0clock/smartcar2022/hardware/电机驱动/danqu.PcbDoc.htm

Reporting Options

# File in Previous Format

Date | : | 2022/7/8
Time | : | 20:59:29
Filename | : | C:\Users\Jay\Desktop\my-smart-car-2022\hardware\든샙혜땡\danqu.PcbDoc

Version | Warning

This file was generated by an earlier version of the software
