0clock/smartcar2022/openart/README.md

# openart部分

1. openart1的功能是开始时识别A4纸上的坐标点，以及在搬运的过程中寻找图片位置发送给rt1064，用来纠正小车位置。
2. openart2的功能是识别图片的内容
