0clock/smartcar2022/images/m车模底盘.jpg

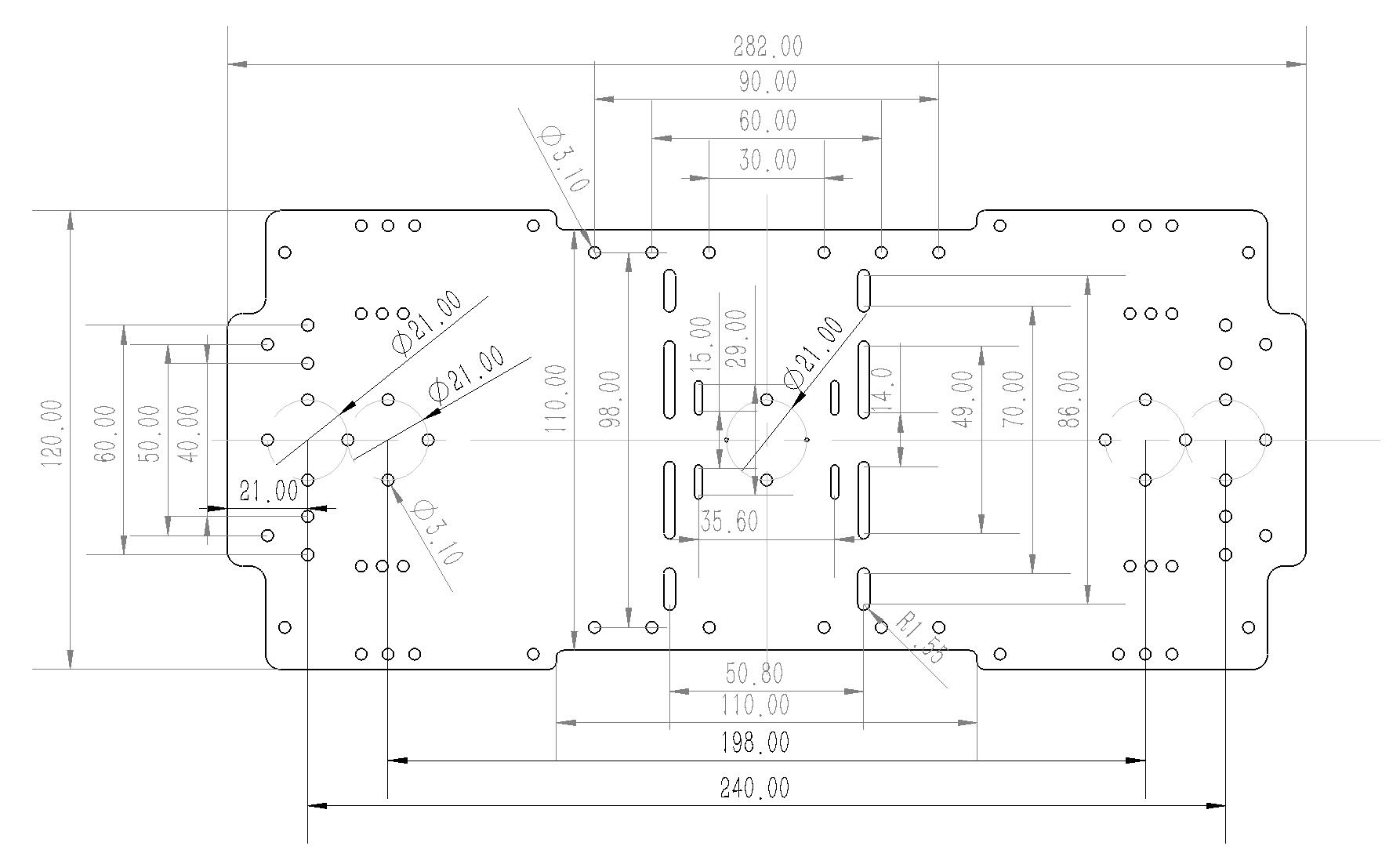
images/m车模底盘.jpg
