0clock/smartcar2022/images/Schematic_自然选择号_2022-07-16.png

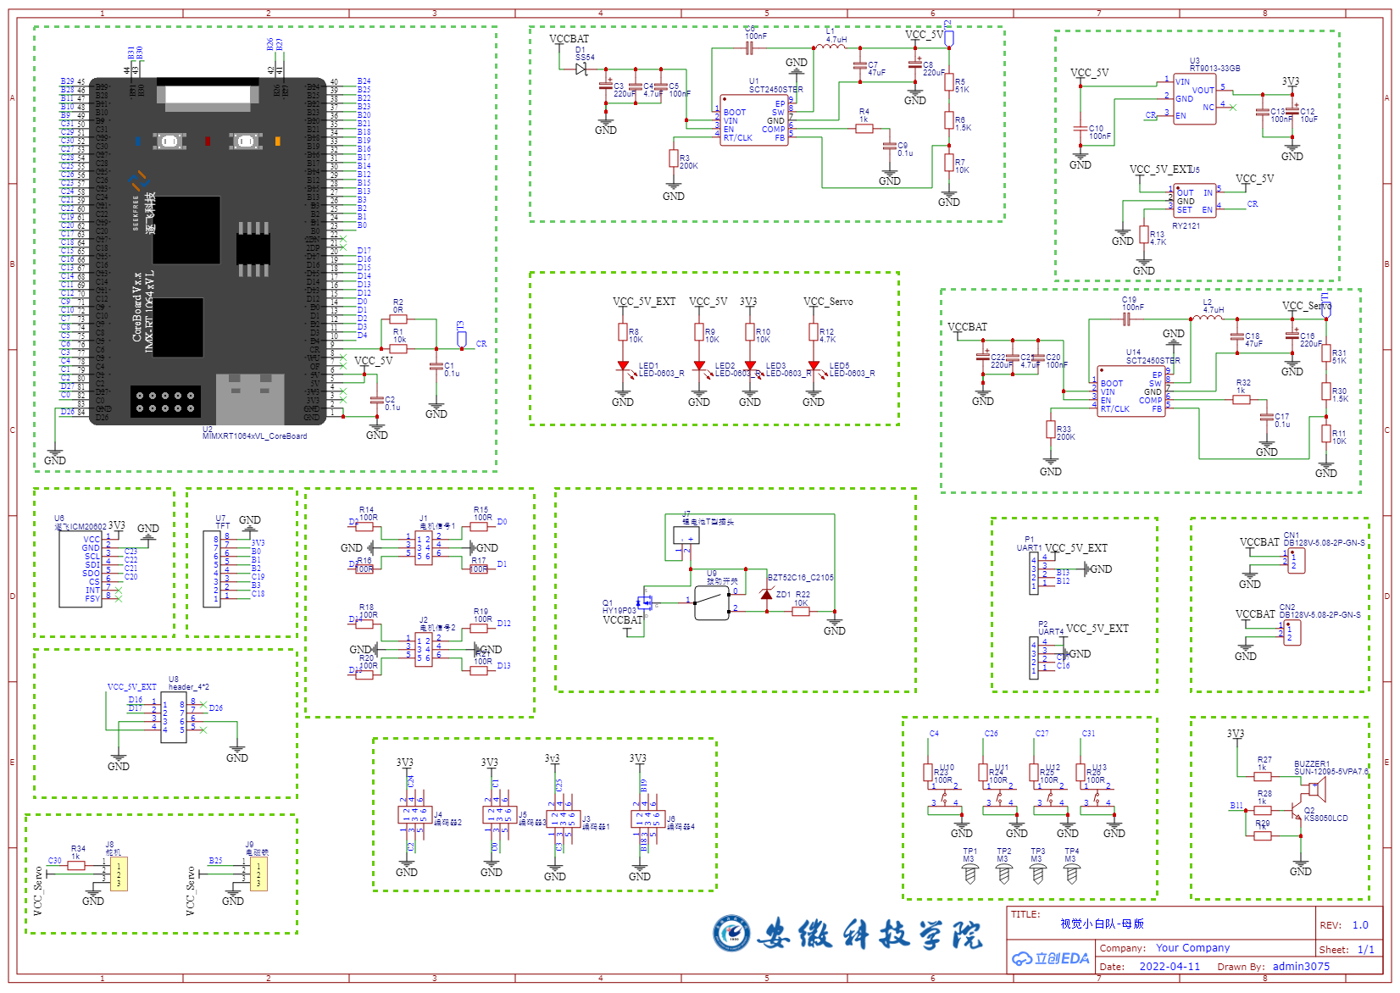
images/Schematic_自然选择号_2022-07-16.png
