0clock/smartcar2022/images/小车1.jpg

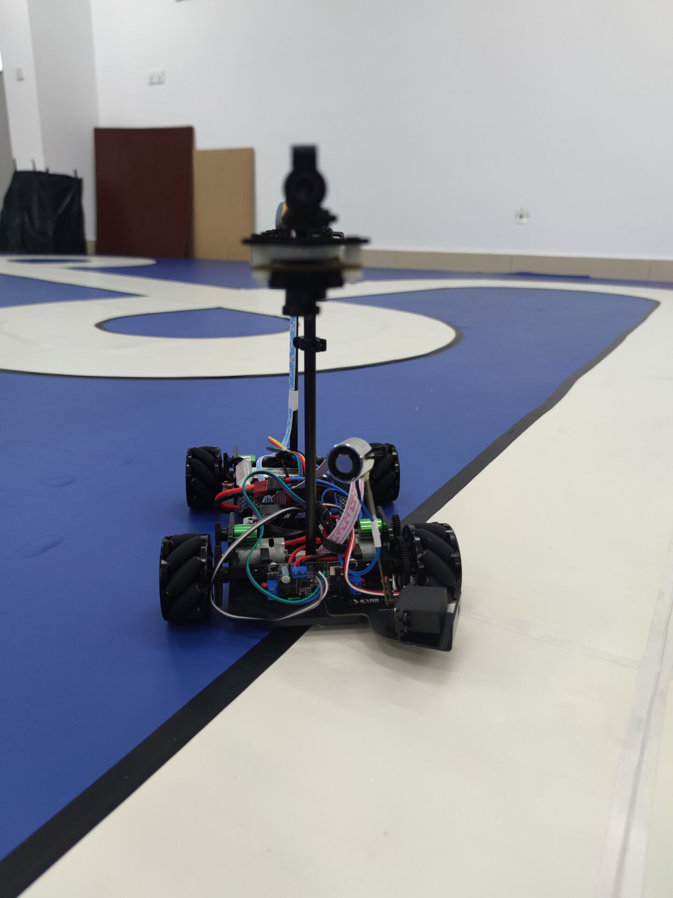
images/小车1.jpg
