0clock/smartcar2022/images/小车3.jpg

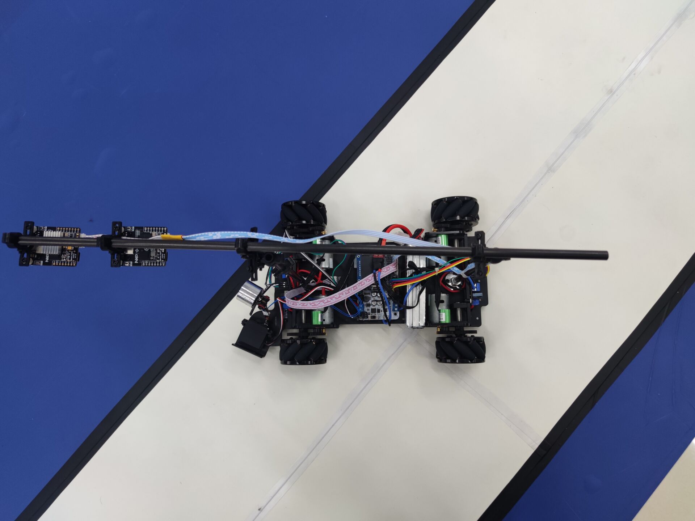
images/小车3.jpg
