0clock/smartcar2022/images/母版.jpg

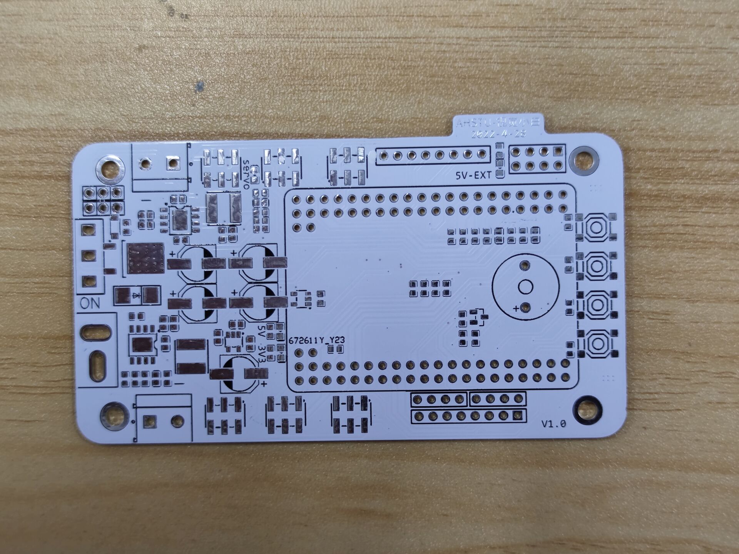
images/母版.jpg
