0clock/smartcar2022/images/电机驱动.jpg

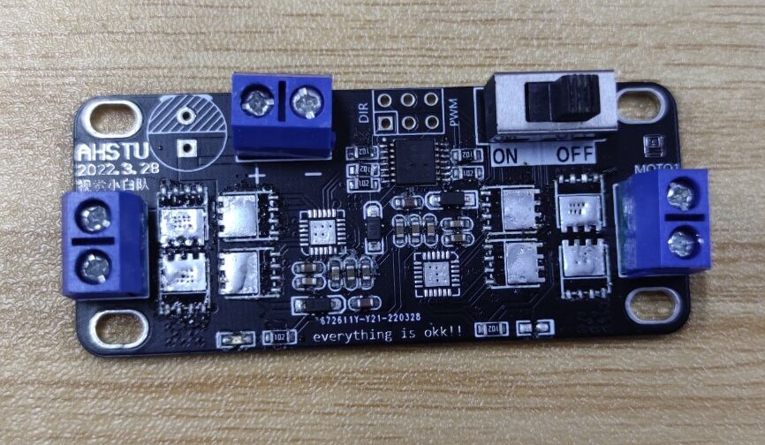
images/电机驱动.jpg
