0clock/smartcar2022/images/电机驱动原理图.png

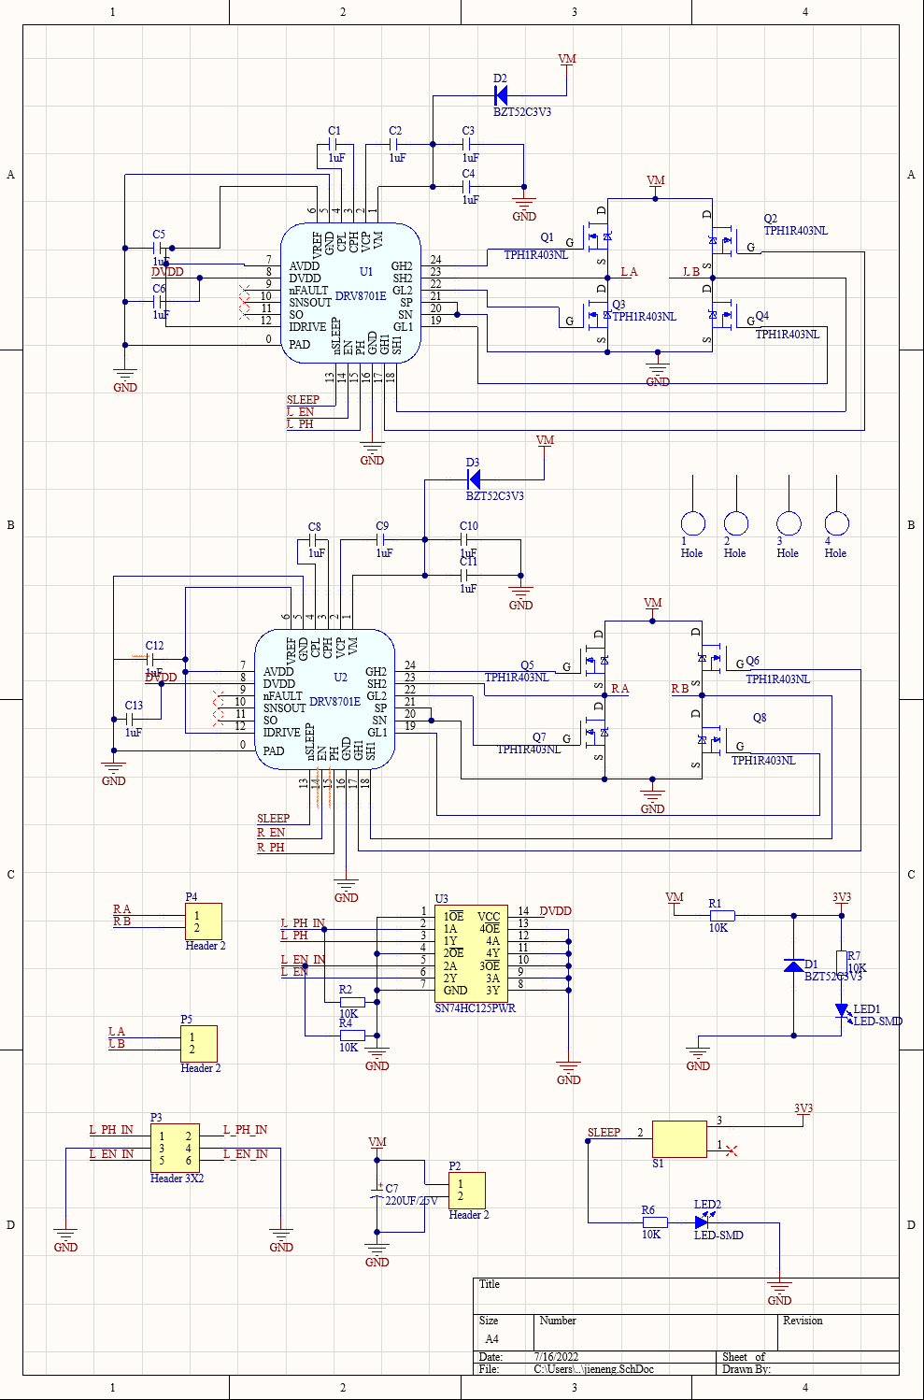
images/电机驱动原理图.png
