0clock/smartcar2022/(list of files, drawings)

Other design files:
hardware/电机驱动/jieneng.SchDoc
hardware/电机驱动/电机驱动工程/电机驱动工程.PrjPcb
