0clock/smartcar2022/rt1064/Project/CODE/encoder.h

#ifndef _encoder_h
#define _encoder_h

#include "headfile.h"

extern uint16 speed_l, speed_r;
extern int32 encoder1,encoder2,encoder3,encoder4;//编码器的值
extern int32 RC_encoder1,RC_encoder2,RC_encoder3,RC_encoder4;//滤波之后encoder的值

void encoder_init(void);
void encoder_get(void);
#endif
