0clock/smartcar2022/rt1064/Project/CODE/smotor.h

#ifndef _smotor_h
#define _smotor_h

#include "headfile.h"


void smotor_init(void);
void smotor1_control(int16 duty);
void grab_picture();
void place_picture();

void smotor2_control(int16 duty);
void smotor3_control(int16 duty);
    

#endif
