0clock/smartcar2022/rt1064/Project/CODE/display.c

#include "headfile.h"
#include "encoder.h"
#include "display.h"
#include "location.h"
#include "button.h"
#include "attitude_solution.h"
#include "MahonyAHRS.h"
#include "imgproc.h"
#include "flash_param.h"
#include "carmove.h"
#include "openart_mini.h"

enum Gui_Page Page_Number=InfoPage;
bool Gui_Page_Active=true;

extern image_t img_raw;
extern image_t img_thres;
extern image_t img_line;
extern float ahrs_kp;
extern int tempTest;
extern double getAngel_k;

extern float pictureP,pictureI,pictureD;


void GUI_Motor(){
    ips114_showstr(0,1,"Encoder:");
    ips114_showint16(5,2,RC_encoder1);
    ips114_showint16(5,3,RC_encoder2);
    ips114_showint16(5,4,RC_encoder3);
    ips114_showint16(5,5,RC_encoder4);
    ips114_showstr(80,0,"Mil:");
    ips114_showint16(85,1,Car.MileageX);
    ips114_showint16(85,2,Car.MileageY);
    ips114_showstr(80,3,"Dis:");
    ips114_showint16(85,4,Car.DistanceX);
    ips114_showint16(85,5,Car.DistanceY);

    ips114_showstr(160,2,"Speed");
    ips114_showfloat(165,3,Car.Speed_X,2,3);
    ips114_showfloat(165,4,Car.Speed_Y,2,3);
    ips114_showfloat(165,5,Car.Speed_Z,2,3);
}

void GUI_icm20602(){
    ips114_showstr(0,0,"INFO:");
    ips114_showstr(0,1,"Angel:");
    ips114_showfloat(5,2,Car.Angel,3,4);
    ips114_showstr(0,3,"An_Tar:");
    ips114_showint16(5,4,Car.Angel_Target);

    ips114_showstr(0,5,"getAngel_k:");
    //ips114_showint8(220,0,Car.Position_Pointer);
    ips114_showfloat(5,6,getAngel_k,1,10);

    if(havePicture) {
        ips114_showstr(80, 0, "FindPicture!");
    }else{
        ips114_showstr(80, 0, "NonePicture!");
    }
    ips114_showstr(80,1,"NowPoint:");
    ips114_showint8(85,2,Car.x);
    ips114_showint8(120,2,Car.y);

    ips114_showstr(80,3,"picture_type:");
    ips114_showint8(85,4,picture_type);
}


void GUI_TargetPoint(){
    //ips114_drawRectangle(55, 11, 265, 161,GREEN);
    ips114_showstr(200,0,"err:");
    ips114_showint8(200,1,edge_rotation[0]);
    ips114_showint8(200,2,edge_rotation[1]);
    for(int i=0;i<locate_sz;i++){
        ips114_drawCircle(55+originMap[i][0]*6,161-originMap[i][1]*6,1,WHITE);
//        if(i<=8) {
//            ips114_showint8(50, i, originMap[i][0]);
//            ips114_showint8(90, i , originMap[i][1]);
//        }else{
//            ips114_showint8(180,i-9,originMap[i][0]);
//            ips114_showint8(220,i-9,originMap[i][1]);
//        }
        //ips114_showint8(55+originMap[i][0]*6,(161-originMap[i][1]*6)/16-1,originMap[i][0]);
        //ips114_drawline(55+originMap[i][0]*6,161-originMap[i][1]*6,240+originMap[i+1][0]*6,80-originMap[i+1][1]*6,WHITE);
    }
    //ips114_drawpoint(Car.x,Car.y,RED);
}

void config_page(){
    uint8_t line=1;
    switch (config_action) {
        case MileageX:
            ips114_showstr(10,line,"#");
            break;
        case MileageY:
            ips114_showstr(10,line+1,"#");
            break;
        case AngelP:
            ips114_showstr(10,line+2,"#");
            break;
        case AngelI:
            ips114_showstr(10,line+3,"#");
            break;
        case AngelD:
            ips114_showstr(10,line+4,"#");
            break;
        case MotorP:
            ips114_showstr(10,line+5,"#");
            break;
        case MotorI:
            ips114_showstr(10,line+6,"#");
            break;
        case MotorD:
            ips114_showstr(10,line+7,"#");
            break;
        default:break;
    }
    ips114_showstr(30,line,"MileKX:");
    ips114_showfloat(100,line,MileageKx,1,5);
    ips114_showfloat(200,line,Car.MileageX,3,2);
    ips114_showstr(30,line+1,"MileKY:");
    ips114_showfloat(100,line+1,MileageKy,1,5);
    ips114_showfloat(200,line+1,Car.MileageY,3,2);
    ips114_showstr(30,line+2,"AngelP:");
    ips114_showfloat(100,line+2,Angel_KP,2,3);
    ips114_showstr(30,line+3,"AngelI:");
    ips114_showfloat(100,line+3,Angel_KI,2,3);
    ips114_showstr(30,line+4,"AngelD:");
    ips114_showfloat(100,line+4,Angel_KD,2,3);
    ips114_showstr(30,line+5,"MotorP:");
    ips114_showfloat(100,line+5,Position_KP,3,2);
    ips114_showstr(30,line+6,"MotorI:");
    ips114_showfloat(100,line+6,Position_KI,3,2);
    ips114_showstr(30,line+7,"MotorD:");
    ips114_showfloat(100,line+7,Position_KD,3,2);
}
void display_page(){
    if(Gui_Page_Active){
        ips114_clear(BLACK);
        Gui_Page_Active=false;
    }
    switch(Page_Number){
        case InfoPage:
            GUI_icm20602();
            break;
        case ConfigPage:
            ips114_showstr(0,0,"Config:");
            config_page();
            // 调试模式下定时写入flash参数
            break;
        case TargetPointPage:
            ips114_showstr(0,0,"Route");
            GUI_TargetPoint();
            break;
        case CameraPage:
            ips114_showstr(0,0,"openart:");
            if(havePicture&&openartMode==get_picture) {
                ips114_showstr(10, 1, "picture:");
                ips114_showint16(10, 2, picture_location[0]);
                ips114_showint16(80, 2, picture_location[1]);
            }
            //ips114_displayimage032_zoom1(mt9v03x_csi_image[0], MT9V03X_CSI_W  , MT9V03X_CSI_H, 66, 26, MT9V03X_CSI_W, MT9V03X_CSI_H);
            //ips114_showfloat(80,0,thres,3,2);
            //mt9v03x_csi_finish_flag = 0;	//清除采集完成标志位
            //ImageHandel();
            //ips114_displayimage032_zoom1(img_thres.data, MT9V03X_CSI_W, MT9V03X_CSI_H, 66, 26, MT9V03X_CSI_W, MT9V03X_CSI_H);
            //ips114_displayimage032_zoom(img_thres.data, MT9V03X_CSI_W, MT9V03X_CSI_H, 240, 135);	//显示摄像头图像
            //ips114_displayimage032_zoom(img_raw.data, MT9V03X_CSI_W, MT9V03X_CSI_H, 240, 135);	//显示摄像头图像
//            ips114_drawline(66+Xt,26+Yl,66+Xt,26+Yl,BLUE);
//            ips114_drawline(66+Xt,26+Yr,66+Xb,26+Yr,BLUE);
//            ips114_drawline(66+Xb,26+Yr,66+Xb,26+Yl,BLUE);
//            ips114_drawline(66+Xb,26+Yl,66+Xt,26+Yl,BLUE);
            break;
        case AboutPage:
            ips114_showstr(0,0,"Control:");
            GUI_Motor();
            break;
    }
}


void display_entry(void *parameter)
{
    //角度环测试
//	ips114_clear(BLACK);
//    rt_thread_delay(5000);
//    Car.Angel_Target=10;
//    rt_thread_delay(1000);
//    Car.Angel_Target=100;
//    rt_thread_delay(1500);
//    Car.Angel_Target=-179;
//    rt_thread_delay(1500);
//    Car.Angel_Target=170;
//    rt_thread_delay(1500);
//    Car.Angel_Target=0;
//    rt_thread_delay(1500);
//    Car.Angel_Target=-179;
//    rt_thread_delay(1500);
//    Car.Angel_Target=0;
//    rt_thread_delay(1500);
//    Car.Angel_Target=90;
//    rt_thread_delay(1500);
//    Car.Angel_Target=-90;
//    rt_thread_delay(1500);
//    Car.Angel_Target=180;
//    rt_thread_delay(1500);
//    Car.Angel_Target=0;
    while(1){
        display_page();
        //ips114_showstr(10,0,"camera");
        //ips114_displayimage032_zoom1(mt9v03x_csi_image[0], MT9V03X_CSI_W, MT9V03X_CSI_H, 66, 26, MT9V03X_CSI_W, MT9V03X_CSI_H);
    }


}




void display_init(void)
{
    rt_thread_t tid;
    
    //初始化屏幕
    //ips114_init();
    ips114_clear(BLACK);

    //创建显示线程 优先级设置为31
    tid = rt_thread_create("display", display_entry, RT_NULL, 1024, 31, 16);
    
    //启动显示线程
    if(RT_NULL != tid)
    {
        rt_thread_startup(tid);
    }
}
