0clock/smartcar2022/rt1064/Project/CODE/openart_mini.c

#include "openart_mini.h"
#include "location.h"



int32 picture_location[2]={0};

uint8               openart_rx_buffer;
lpuart_transfer_t   openart_receivexfer;
lpuart_handle_t     openart_g_lpuartHandle;

uint8               openart1_rx_buffer;
lpuart_transfer_t   openart1_receivexfer;
lpuart_handle_t     openart1_g_lpuartHandle;

uint8 openartBuffer=0;

enum picture_type picture_type;
enum picture_big_type pictureBigType=animal;
enum openart_mode openartMode=get_map;
bool havePicture;
bool isDetection=false;
uint8 nowpointmp=0;
uint8 edge_rotation[2]={0};


void openart_uart1_callback(LPUART_Type *base, lpuart_handle_t *handle, status_t status, void *userData)
{
    static int rx_num = 0;
    static bool isgetmap=false,finshgetmap=false;
    if(kStatus_LPUART_RxIdle == status) {
        if (openartMode == get_map) {
            if(openart_rx_buffer==0xFD){
                isgetmap=true;
                rx_num=0;
                nowpointmp=0;
            }else if(openart_rx_buffer==0xFC){
                isgetmap=false;
                rx_num=0;
            }else if(openart_rx_buffer==0xDD){
                finshgetmap=true;
                openartMode=get_picture;
                rx_num=0;
            }else {
                if (isgetmap) {
                    if (rx_num % 2 == 0) {
                        originMap[nowpointmp][0] = openart_rx_buffer;
                    } else {
                        originMap[nowpointmp][1] = openart_rx_buffer;
                        nowpointmp++;
                    }
                    rx_num++;
                } else {
                    edge_rotation[rx_num] = openart_rx_buffer;
                    rx_num++;
                }
            }
        }
    }


    if (openartMode == get_picture) {

        if (openart_rx_buffer == 0xFE) {//没有图片标志
            havePicture = false;
            rx_num=88;
        }
        if (openart_rx_buffer == 0xFF){//有图片的时候，接收图片位置
            rx_num = 0;
        } else if (rx_num < 2) {
            picture_location[rx_num] = openart_rx_buffer;
            rx_num++;
            havePicture = true;
        }
    }
    handle->rxDataSize = openart_receivexfer.dataSize;  //还原缓冲区长度
    handle->rxData = openart_receivexfer.data;          //还原缓冲区地址
}

void openart1_uart1_callback(LPUART_Type *base, lpuart_handle_t *handle, status_t status, void *userData)
{
    static int rx_num = 0;
    if(kStatus_LPUART_RxIdle == status)
    {
        if(openart1_rx_buffer==0xFF){
            rx_num=0;
            isDetection=true;
        }else {
            if (isDetection) {
                picture_type =openart1_rx_buffer;
                switch (picture_type) {
                    case apple:
                    case banana:
                    case durian:
                    case grape:
                    case orange:
                        pictureBigType=fruit;
                        break;
                    case cat:
                    case cow:
                    case dog:
                    case horse:
                    case pig:
                        pictureBigType=animal;
                        break;
                    case bus:
                    case car:
                    case plane:
                    case ship:
                    case trains:
                        pictureBigType=vehicle;
                        break;
                    default:break;
                }
            }else{
                picture_type=0;
                pictureBigType=animal;
            }
        }
    }
    handle->rxDataSize = openart1_receivexfer.dataSize;  //还原缓冲区长度
    handle->rxData = openart1_receivexfer.data;          //还原缓冲区地址
}


void openart_mini(void)
{
    uart_init(USART_4, 115200, UART4_TX_C16, UART4_RX_C17);


    //配置串口接收的缓冲区及缓冲区长度
    openart_receivexfer.dataSize = 1;
    openart_receivexfer.data = &openart_rx_buffer;


    openart1_receivexfer.dataSize = 1;
    openart1_receivexfer.data = &openart1_rx_buffer;


    //设置中断函数及其参数
    uart_set_handle(USART_4, &openart_g_lpuartHandle, openart_uart1_callback, NULL, 0, openart_receivexfer.data, 1);
    //uart_set_handle(USART_1, &csi_g_lpuartHandle, uart1_call_back, NULL, 0, buff, 1);
    NVIC_SetPriority(LPUART4_IRQn, 0);         //设置串口中断优先级 范围0-15 越小优先级越高
    uart_rx_irq(USART_4, 1);

    uart_init (USART_1, 115200,UART1_TX_B12,UART1_RX_B13); //初始化串口
    //设置中断函数及其参数
    uart_set_handle(USART_1, &openart1_g_lpuartHandle, openart1_uart1_callback, NULL, 0, openart1_receivexfer.data, 1);
    //uart_set_handle(USART_1, &csi_g_lpuartHandle, uart1_call_back, NULL, 0, buff, 1);
    NVIC_SetPriority(LPUART1_IRQn, 1);         //设置串口中断优先级 范围0-15 越小优先级越高
    uart_rx_irq(USART_1, 1);
}
