0clock/smartcar2022/rt1064/Project/CODE/MahonyAHRS.h

//=====================================================================================================
// MahonyAHRS.h
//=====================================================================================================
//
// Madgwick's implementation of Mayhony's AHRS algorithm.
// See: http://www.x-io.co.uk/node/8#open_source_ahrs_and_imu_algorithms
//
// Date			Author			Notes
// 29/09/2011	SOH Madgwick    Initial release
// 02/10/2011	SOH Madgwick	Optimised for reduced CPU load
//
//=====================================================================================================
#ifndef MahonyAHRS_h
#define MahonyAHRS_h

//----------------------------------------------------------------------------------------------------
// Variable declaration

extern volatile float twoKp;          // 2 * proportional gain (Kp)
extern volatile float twoKi;          // 2 * integral gain (Ki)
extern volatile float q0, q1, q2, q3; // quaternion of sensor frame relative to auxiliary frame

typedef struct {
    float gyro_x;
    float gyro_y;
    float gyro_z;
    float acc_x;
    float acc_y;
    float acc_z;
    float mag_x;
    float mag_y;
    float mag_z;
} arhs_source_param_t;

typedef struct {
    float Xdata;
    float Ydata;
    float Zdata;
} mag_zero_param_t;

typedef struct {
    float Xdata;
    float Ydata;
    float Zdata;
} gyro_zero_param_t;

typedef struct {
    float pitch;    //俯仰角
    float roll;     //偏航角
    float yaw;       //翻滚角
} arhs_euler_param_t;

extern arhs_euler_param_t arhs_data;

//---------------------------------------------------------------------------------------------------
// Function declarations

void MahonyAHRSupdate(float gx, float gy, float gz, float ax, float ay, float az, float mx, float my, float mz);
void MahonyAHRSupdateIMU(float gx, float gy, float gz, float ax, float ay, float az);
void Mahony_computeAngles(void);
void imu_offset_init(void);

#endif
    //=====================================================================================================
    // End of file
    //=====================================================================================================
