0clock/smartcar2022/rt1064/Project/CODE/filter.h

/***************************************************
*
* @file         Road.h
* @brief        传感器数据处理文件
* @version      v1.0
* @date         2022/1/18
*
***************************************************/
#ifndef _FILTER_h
#define _FILTER_h
#include <stdint.h>
//-----------------------宏-----------------------//
#define Filter_N 10	//连续获取10个陀螺仪数值
//--------------------全局变量---------------------//
extern float yaw_Filter;
//---------------------结构体---------------------//
struct RC_Para
{
    float temp;  //暂存值,存储RC_baro
    float value; //滤波值
    float RC;    //低通滤波参数
};
typedef struct RC_Para *RC_Filter_pt;



/***************************************************************************/
float Kalmen_getAngle(float now_angle, float now_rate,float dt);
float complementary_filter2(float now_angle, float now_rate, float dt);
float Movingaverage_filter(float value,float Filter_buff[]);
float RCFilter(float value,RC_Filter_pt Filter);
int Angel_PID(int NowAngel,int TargetAngel);

#endif
