0clock/smartcar2022/rt1064/Project/CODE/vofa_imageformat.h

enum ImgFormat {
    Format_Invalid,
    Format_Mono,
    Format_MonoLSB,
    Format_Indexed8,
    Format_RGB32,
    Format_ARGB32,
    Format_ARGB32_Premultiplied,
    Format_RGB16,
    Format_ARGB8565_Premultiplied,
    Format_RGB666,
    Format_ARGB6666_Premultiplied,
    Format_RGB555,
    Format_ARGB8555_Premultiplied,
    Format_RGB888,
    Format_RGB444,
    Format_ARGB4444_Premultiplied,
    Format_RGBX8888,
    Format_RGBA8888,
    Format_RGBA8888_Premultiplied,
    Format_BGR30,
    Format_A2BGR30_Premultiplied,
    Format_RGB30,
    Format_A2RGB30_Premultiplied,
    Format_Alpha8,
    Format_Grayscale8,
    
    // 以下格式发送时，IMG_WIDTH和IMG_HEIGHT不需要强制指定，设置为-1即可
    Format_BMP,
    Format_GIF,
    Format_JPG,
    Format_PNG,
    Format_PBM,
    Format_PGM,
    Format_PPM,
    Format_XBM,
    Format_XPM,
    Format_SVG,
};

//下面是失误：没有必要用结构体打包数据，那样太慢了
//#define CHANNEL_CNT 10
//typedef struct VOFA_FRAME0{								//第一类数据包
//		float channel_data[CHANNEL_CNT];			//不同通道的数据
//		unsigned char tail[4];								//存放数据帧尾:{0x00, 0x00, 0x80, 0x7f}
//}vofa_JF_CH_frame;												//justfloat的float通道模式对应的数据帧类型

//typedef struct VOFA_FRAME1{
//		uint32_t preframe[7];											//图片的前导帧
//		char* image;													//以byte流的方式传输图像
//}vofa_JF_IMAGE_frame;											//justfloat的float通道模式对应的数据帧类型

//typedef struct VOFA_FRAME2{
//		float channel_data[CHANNEL_CNT];			//不同通道的数据-------?
//		unsigned char tail[4];								//存放数据帧尾:{0x00, 0x00, 0x80, 0x7f}
//}vofa_FW_CH_frame;												//firewater的float通道模式对应的数据帧类型

//typedef struct VOFA_FRAME3{
//		float channel_data[CHANNEL_CNT];			//不同通道的数据-------?
//		unsigned char tail[4];								//存放数据帧尾:{0x00, 0x00, 0x80, 0x7f}
//}vofa_FW_IMAGE_frame;											//firewater的float通道模式对应的数据帧类型
// 
