0clock/smartcar2022/(commit log)

2022-03-20 3-20-大改动
    [Fabrication Testpoint Report for jieneng.csv, RT1064核心板丝印与芯片引脚对应表格.xlsx, STARTUP.OBJ, cmm_cfg.csv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]
2022-03-24 3-24-add pid
2022-04-19 路径规划 # 路径规划V0.1 ### 单纯根据原点距离计算位置
2022-04-19 删除文件 route.c
2022-04-19 路径规划
2022-04-19 4-19 生日快乐！
2022-04-25 4-25 icm20602
    [RT1064核心板丝印与芯片引脚对应表格.xlsx]
2022-04-27 4-27 icm
    [RT1064核心板丝印与芯片引脚对应表格.xlsx]
2022-04-29 运动学逆解
2022-05-03 5-4 整合路径规划
2022-05-03 5-4 修改位移计算公式
2022-05-04 5-4 摄像头
2022-05-06 5-6 z轴PID
2022-05-06 整理文件目录
    [Assembly Testpoint Report for jieneng.csv, Fabrication Testpoint Report for jieneng.csv, RT1064核心板丝印与芯片引脚对应表格.xlsx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]
2022-05-06 5-6 整理
2022-05-06 5-6 方向換
2022-05-06 5-6 方向闭环
2022-05-06 5-7_移植图像处理库
2022-05-30 变更5-30
2022-06-02 6-3 更改坐标跟新函数和获取目标位置函数 待验证
2022-06-02 6-3 更改坐标跟新函数和获取目标位置函数 待验证（编译通过）
2022-06-24 6-24 图像处理
2022-06-26 6-26 研究图像处理算法，还是不太行
2022-06-27 add RTT
    [RT1064核心板丝印与芯片引脚对应表格.xlsx]
2022-06-27 移植rtt
2022-07-14 增加模型
    [RT1064核心板丝印与芯片引脚对应表格.xlsx, 姿态传感器顶部固定件.stl]
2022-07-14 两个仓库同步
2022-07-15 增加搬运
2022-07-16 7-16 尝试和openart通讯
2023-01-31 整理文件
    [RT1064核心板丝印与芯片引脚对应表格.xlsx, cmm_cfg(1).csv, cmm_cfg.csv, 姿态传感器顶部固定件.stl]
2023-05-05 bug fixed
    [cmm_cfg(1).csv, cmm_cfg.csv]
