0clock/smartcar2022/(notices)

Notices in the files:
rt1064/Project/USER/src/main.c:
Copyright (c) 2019,Öð·É¿Æ¼¼
All rights reserved.
